Jeff-Birt/C2N_Adapter/Images/Adapter Rev6 PCB Bottom.PNG

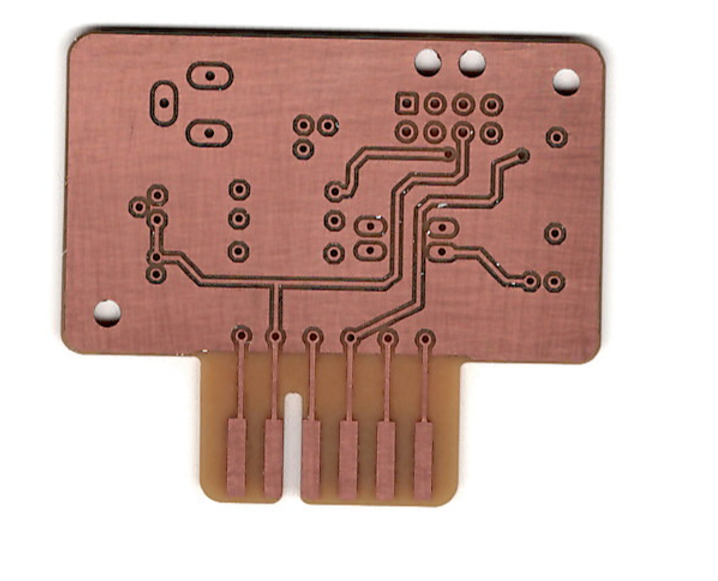
Images/Adapter Rev6 PCB Bottom.PNG
