Jeff-Birt/C2N_Adapter/Images/Adapter Rev6 PCB Top.PNG

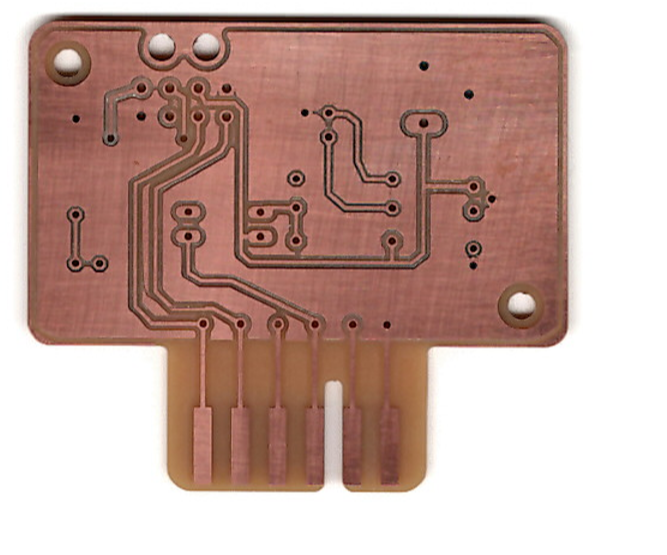
Images/Adapter Rev6 PCB Top.PNG
