Jeff-Birt/C2N_Adapter/Data/Cassette Adapter BOM.xlsx

Manufacturer | Part # | Qty | Description | Source | Price Ea. $ | Price Ext.
For adapter
AdaFruit | 373 | 1 | DC Power Jack, OD-5.5mm, ID-2.1mm | https://www.mouser.com/ProductDetail/485-373 | $0.95 | $0.95
Vishay | IRFD9014PBF | 1 | MOSFET Transistor, power switch | https://www.mouser.com/ProductDetail/844-IRFD9014PBF | $0.95 | $0.95
Molex | 43045-0800 | 1 | 2x4 Right Angle PCB count con. | https://www.mouser.com/ProductDetail/538-43045-0800 | $2.20 | $2.20
Molex | 538-43025-0800 | 1 | 2x4 Male connector housing | https://www.mouser.com/ProductDetail/538-43025-0800 | $0.52 | $0.52
Molex | 43030-0007 | 8 | Female crimp pins for above housing | https://www.mouser.com/ProductDetail/538-43030-0007 | $0.19 | $1.52
ON | LM2931AZ-5.0RPG | 1 | 5V Regulator, TO-92 case | https://www.mouser.com/ProductDetail/863-LM2931AZ-5.0RPG | $0.59 | $0.59
Misc | 2N222A | 1 | NPN Transistor | https://www.bgmicro.com/TRN2N2222AMetal.aspx | $0.27 | $0.27
Misc |  | 2 | 2.2K 1/4W resistor |  | $0.10 | $0.20
Misc |  | 1 | 10K 1/4W resistor |  | $0.10 | $0.10
Misc |  | 1 | 330ohm 1/4W resistor |  | $0.10 | $0.10
Misc |  | 1 | T1-3/4 LED |  | $0.10 | $0.10
Misc |  | 1 | 10uF 16V electrolytic capacitor |  | $0.10 | $0.10
For TI-94/74
Amphenol | 78211-010LF | 1 | 0.1" 1x10 Female housing | https://www.mouser.com/ProductDetail/649-78211-010LF | $1.28 | $1.28
Amphenol | 47715-000LF | 10 | Female crimp pins for above houing | https://www.mouser.com/ProductDetail/649-47715-000LF | $0.42 | $4.20
 |  |  |  | Total |  | $13.08
