Jeff-Birt/C2N_Adapter/HH-3465 Inspired Model/HH-3465 Assembly.stp

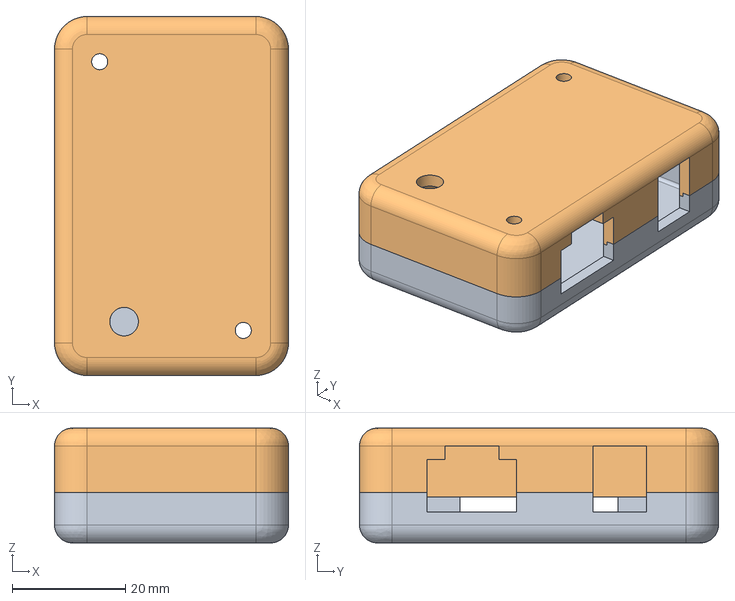
[picture p3: CAD file, 2018-11-23]
HH-3465 Inspired Model/HH-3465 Assembly.stp
41.4 x 63.5 x 20.3 mm
Bottom
Top
