Jeff-Birt/C2N_Adapter/HH-3465 Inspired Model/Top.stp

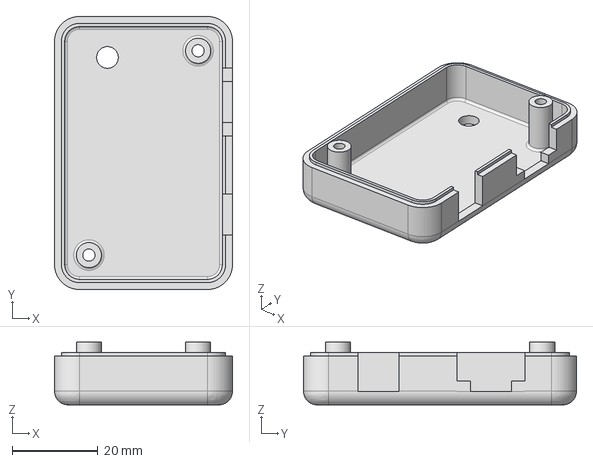
[picture p4: CAD file, 2018-11-23]
HH-3465 Inspired Model/Top.stp
41.4 x 63.5 x 14.6 mm
