Jeff-Birt/C2N_Adapter/HH-3465 Inspired Model/Bottom.stp

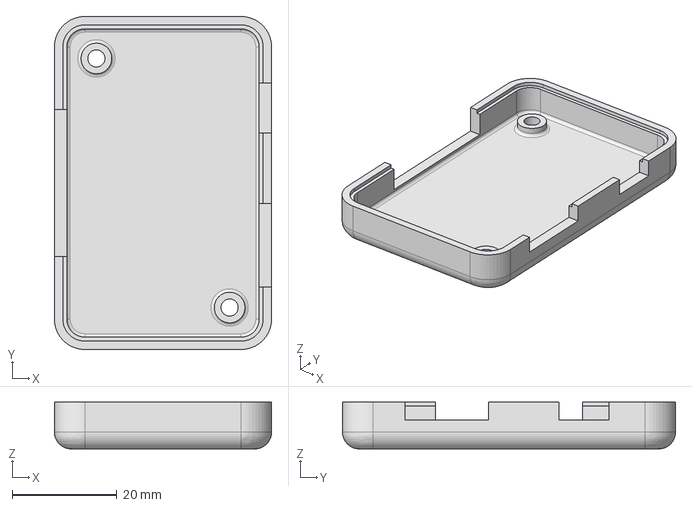
[picture p5: CAD file, 2018-11-23]
HH-3465 Inspired Model/Bottom.stp
41.4 x 63.5 x 8.92 mm
