Jeff-Birt/C2N_Adapter/HH-3465 Inspired Model/hb3465.dxf

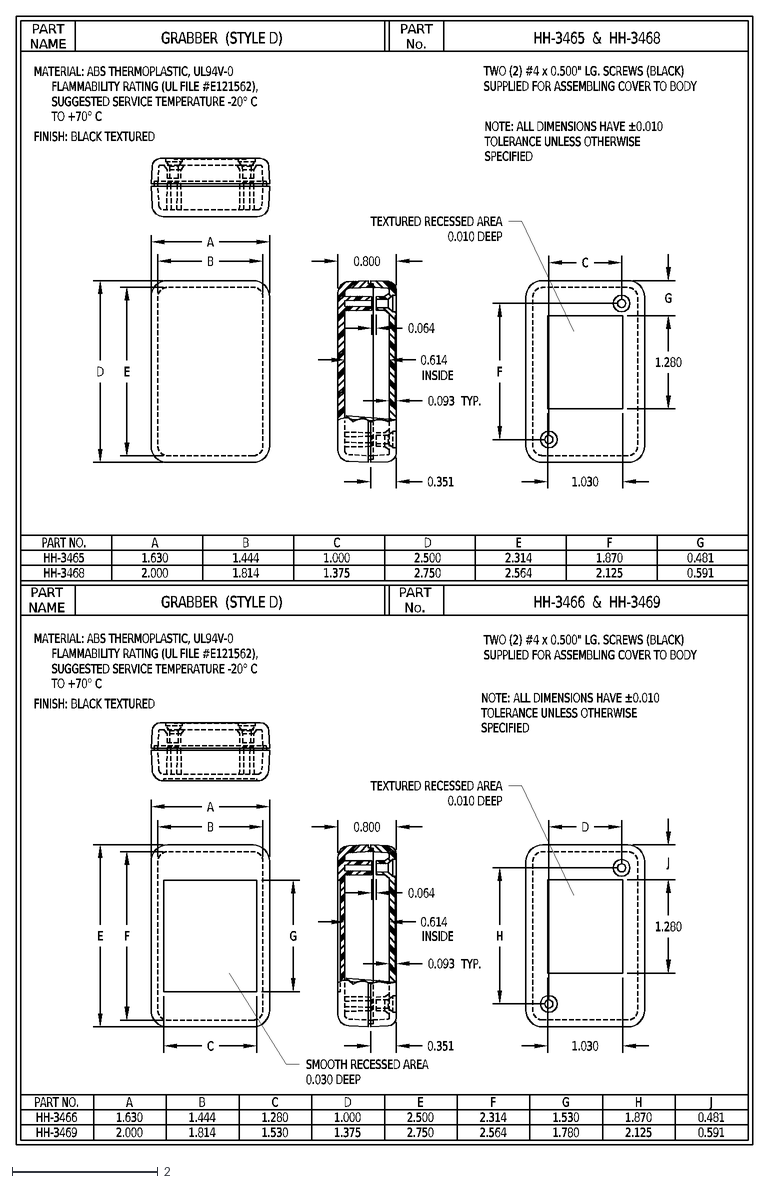
[picture p6: CAD file, 2018-11-23]
HH-3465 Inspired Model/hb3465.dxf
NAME
PART
No.
PART NO.
HH-3466
HH-3469
GRABBER (STYLE D)
TWO (2) #4 x 0.500" LG. SCREWS (BLACK)
SUPPLIED FOR ASSEMBLING COVER TO BODY
NOTE: ALL DIMENSIONS HAVE ±0.010
TOLERANCE UNLESS OTHERWISE
SPECIFIED
0.800
A
E
TYP.
0.093
HH-3465 & HH-3468
HH-3466 & HH-3469
FINISH: BLACK TEXTURED
SUGGESTED SERVICE TEMPERATURE -20° C
FLAMMABILITY RATING (UL FILE #E121562),
MATERIAL: ABS THERMOPLASTIC, UL94V-0
C
G
1.030
1.280
0.351
0.614
B
F
J
D
H
2.000
1.630
1.814
1.444
1.530
1.375
1.000
2.750
2.500
2.564
2.314
1.780
2.125
1.870
0.591
0.481
HH-3468
HH-3465
TEXTURED RECESSED AREA
0.010 DEEP
INSIDE
SMOOTH RECESSED AREA
0.030 DEEP
0.064
TO +70° C
