Jeff-Birt/C2N_Adapter/(list of files, cad)

Other CAD files:
HH-3465 Inspired Model/3D Print Files/Bottom.stl
HH-3465 Inspired Model/3D Print Files/Top.stl
HH-3465 Inspired Model/Bottom.igs
HH-3465 Inspired Model/Bottom.ipt
HH-3465 Inspired Model/HH-3465 Assembly.dwg
HH-3465 Inspired Model/HH-3465 Assembly.iam
HH-3465 Inspired Model/HH-3465 Assembly.igs
HH-3465 Inspired Model/Top.igs
HH-3465 Inspired Model/Top.ipt
