Jeff-Birt/C2N_Adapter/Eagle PCB Files V6/Cassette adapter V6 Schematic.pdf

4 | 3 | 2 | 1
8 | 7 | 6 | 5

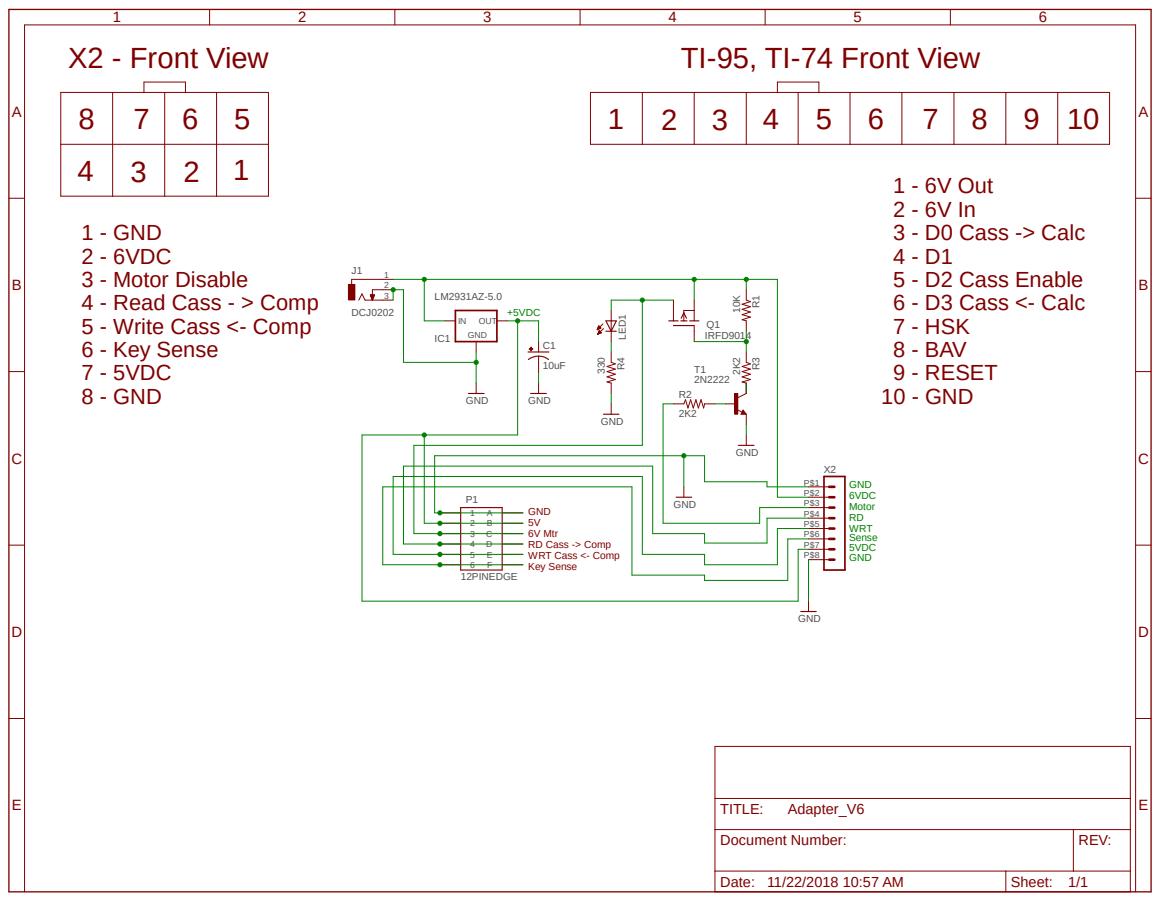
[picture p7: page 1]

TI-95, TI-74 Front View

Document Number: | REV:

Date: 11/22/2018 10:57 AM | Sheet: 1/1
