Jeff-Birt/C2N_Adapter/Data/Electronic Components/Connector_901560150_sd.pdf

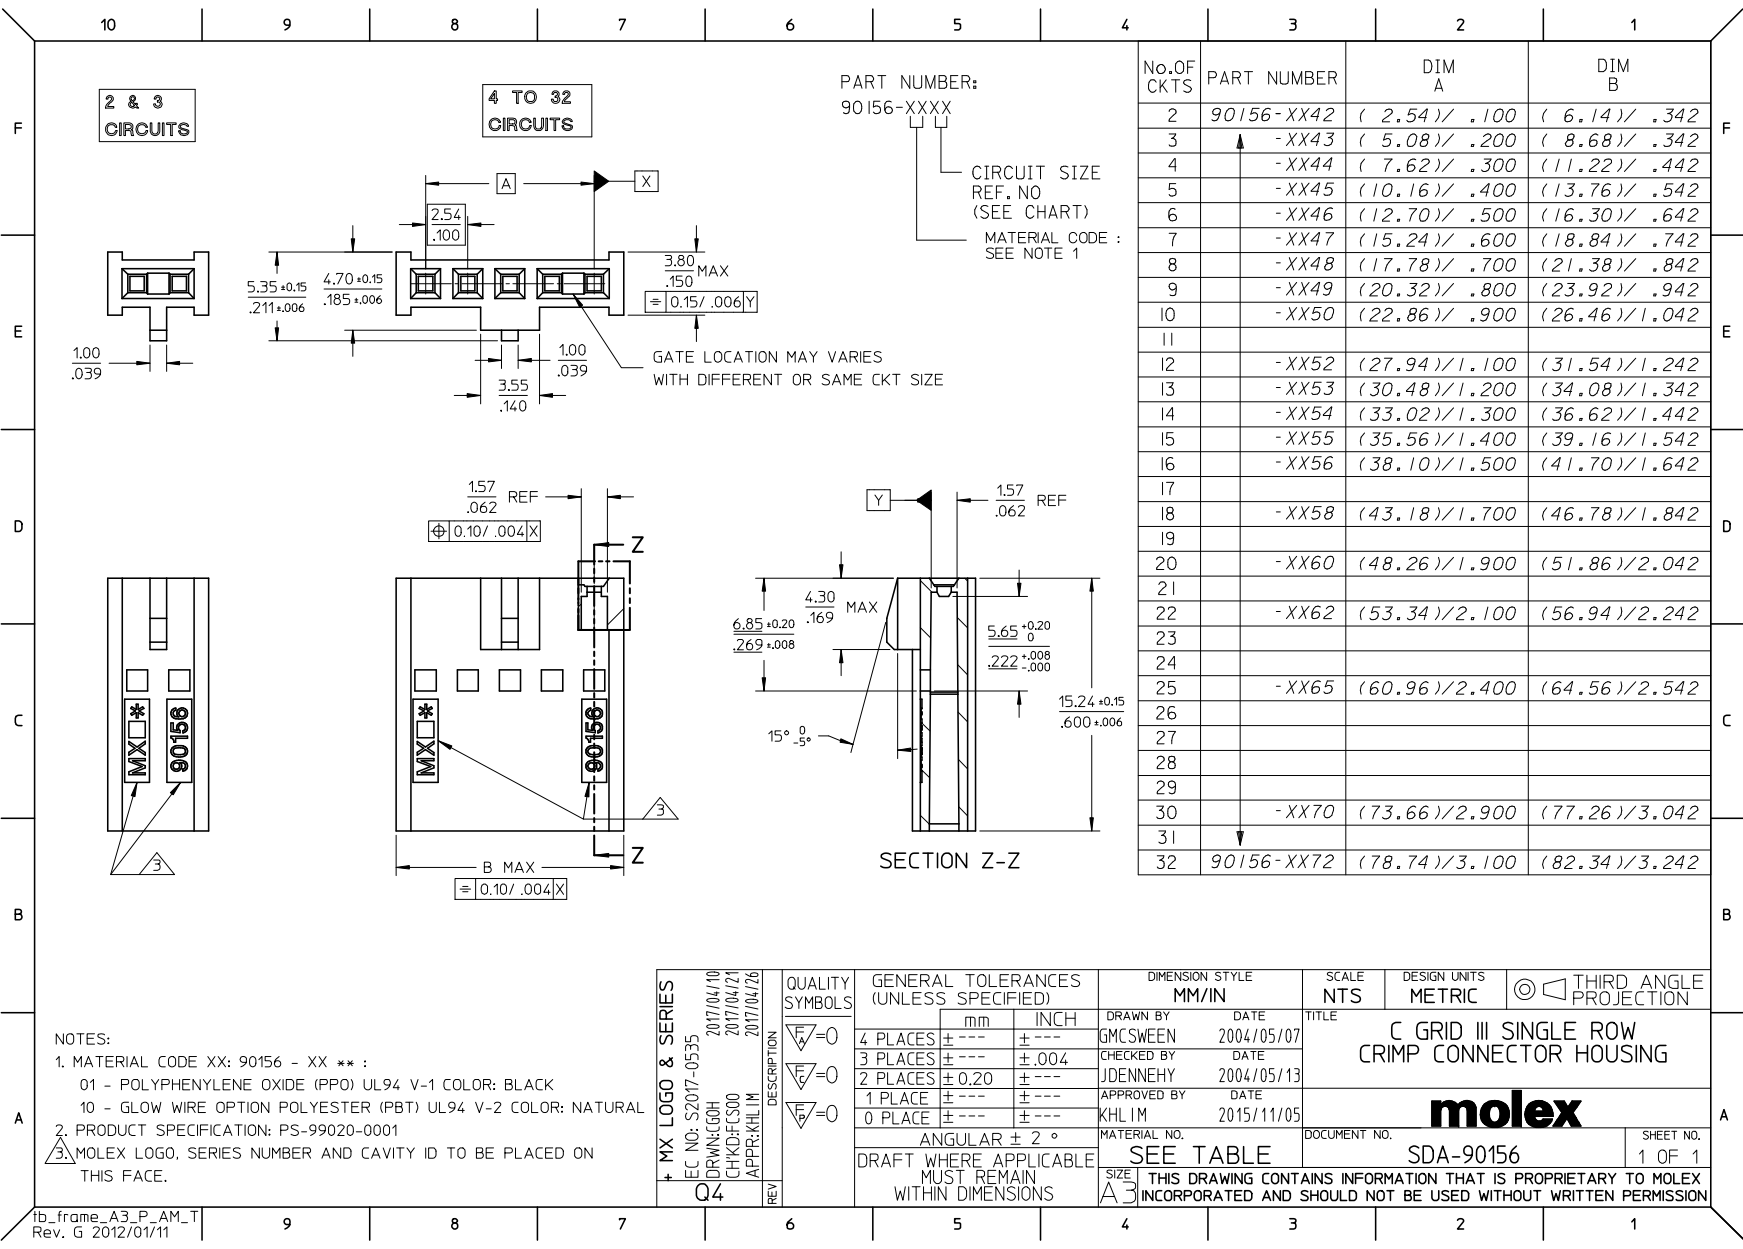
[picture p8: page 1]
