Jeff-Birt/C2N_Adapter/Data/Electronic Components/Molex_430300007_sd.pdf

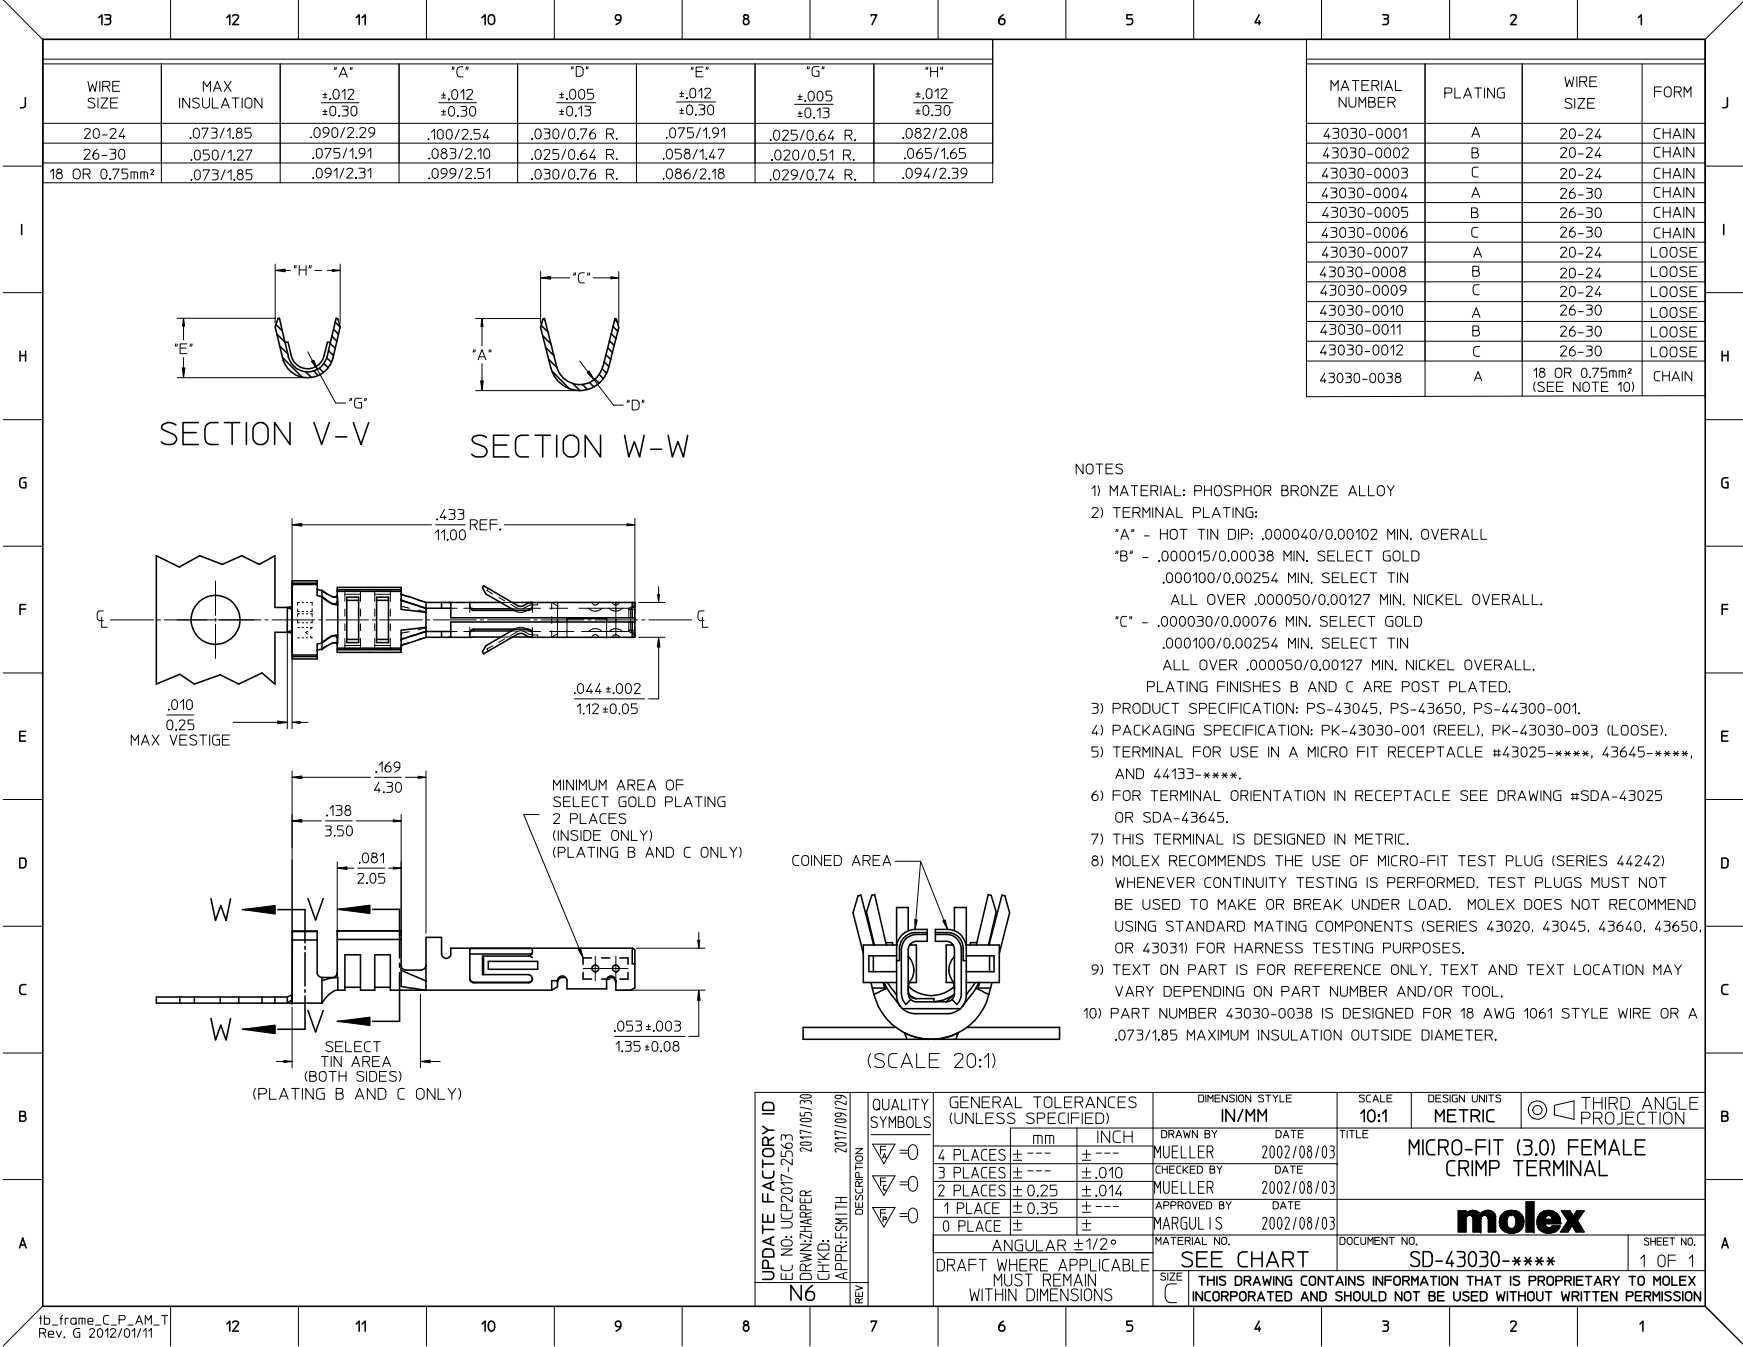
[picture p9: page 1]
