Jeff-Birt/C2N_Adapter/Data/Electronic Components/Molex_430450800_sd.pdf

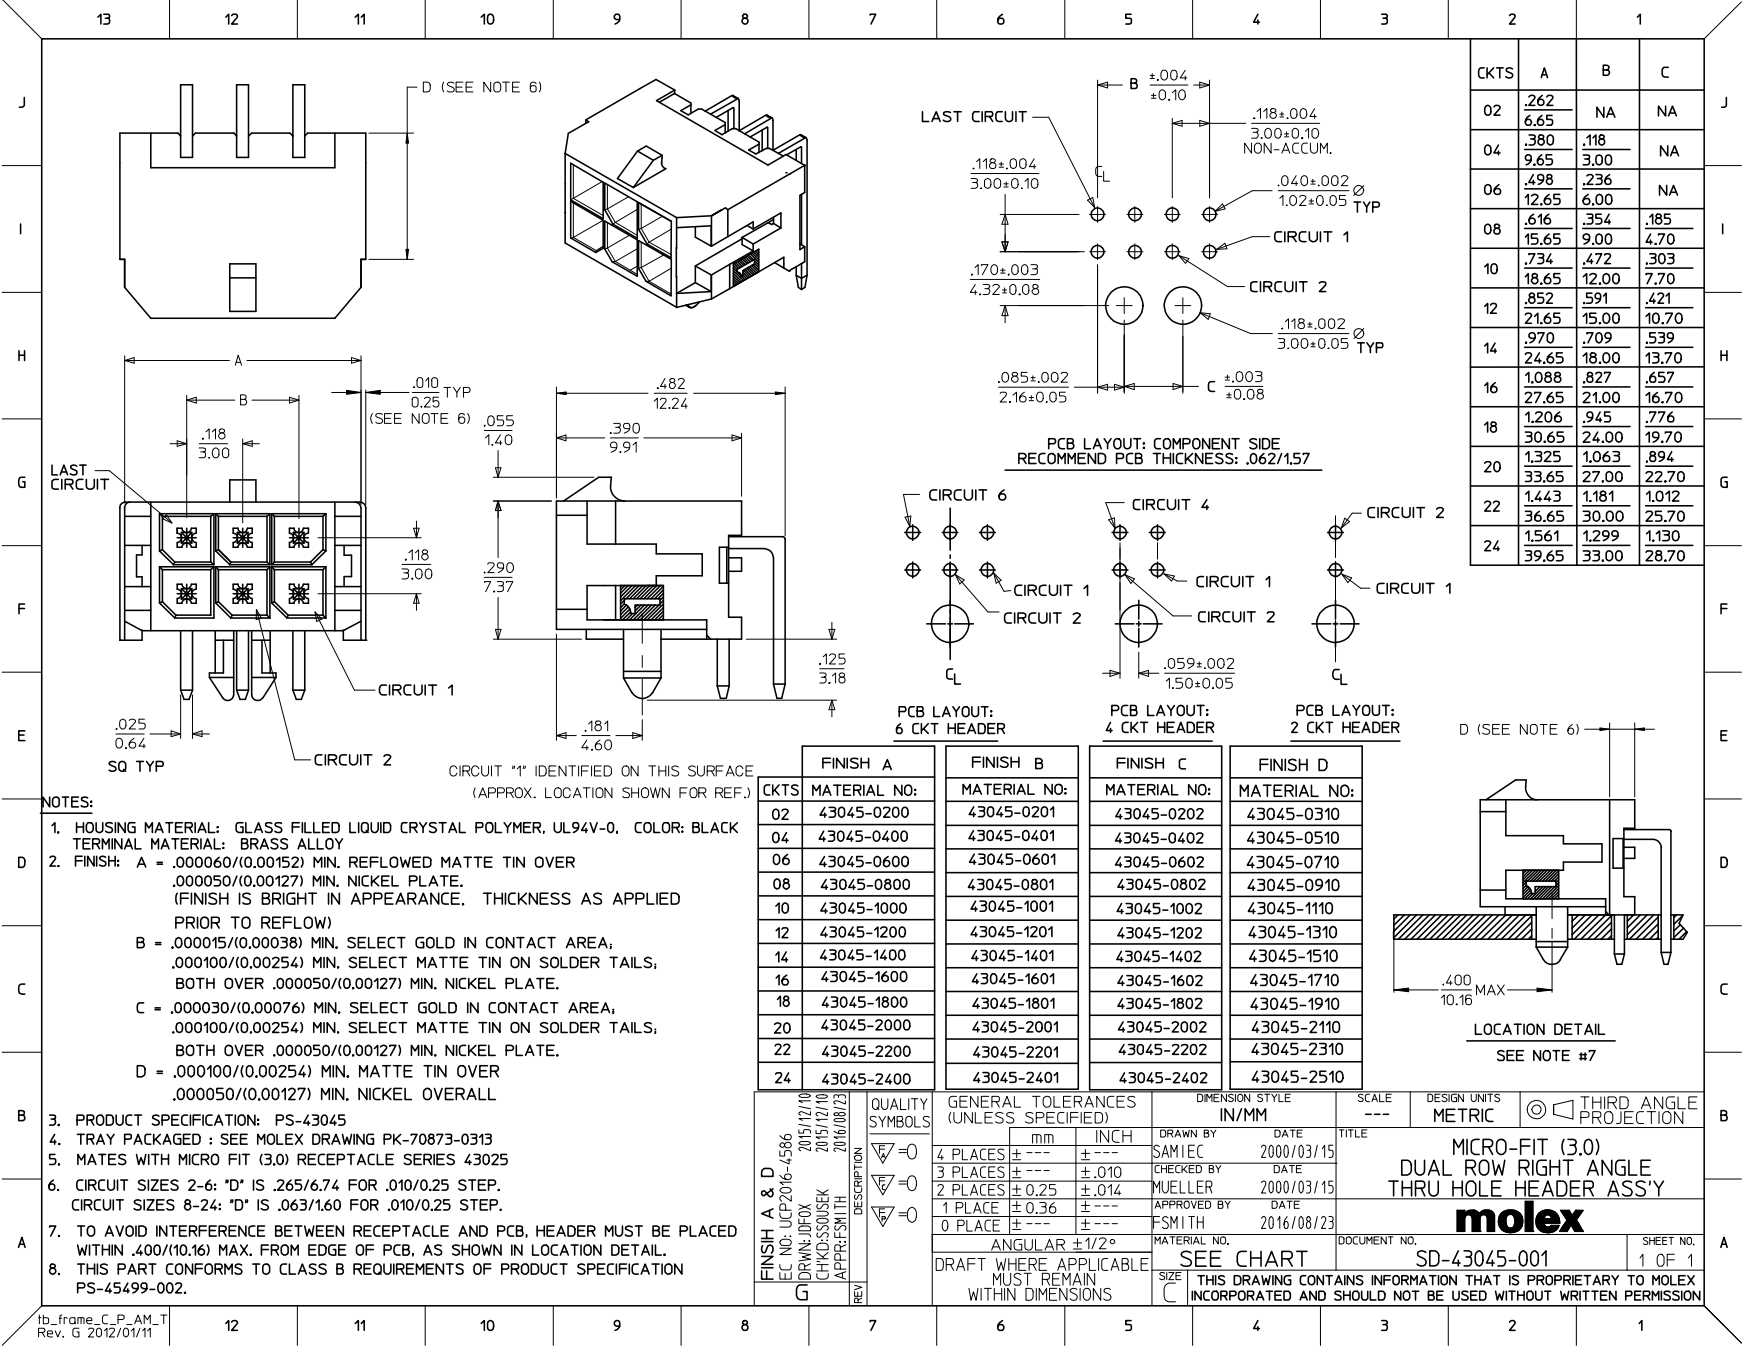
[picture p10: page 1]
