Jeff-Birt/C2N_Adapter/Data/Enclosures/hb3465.pdf

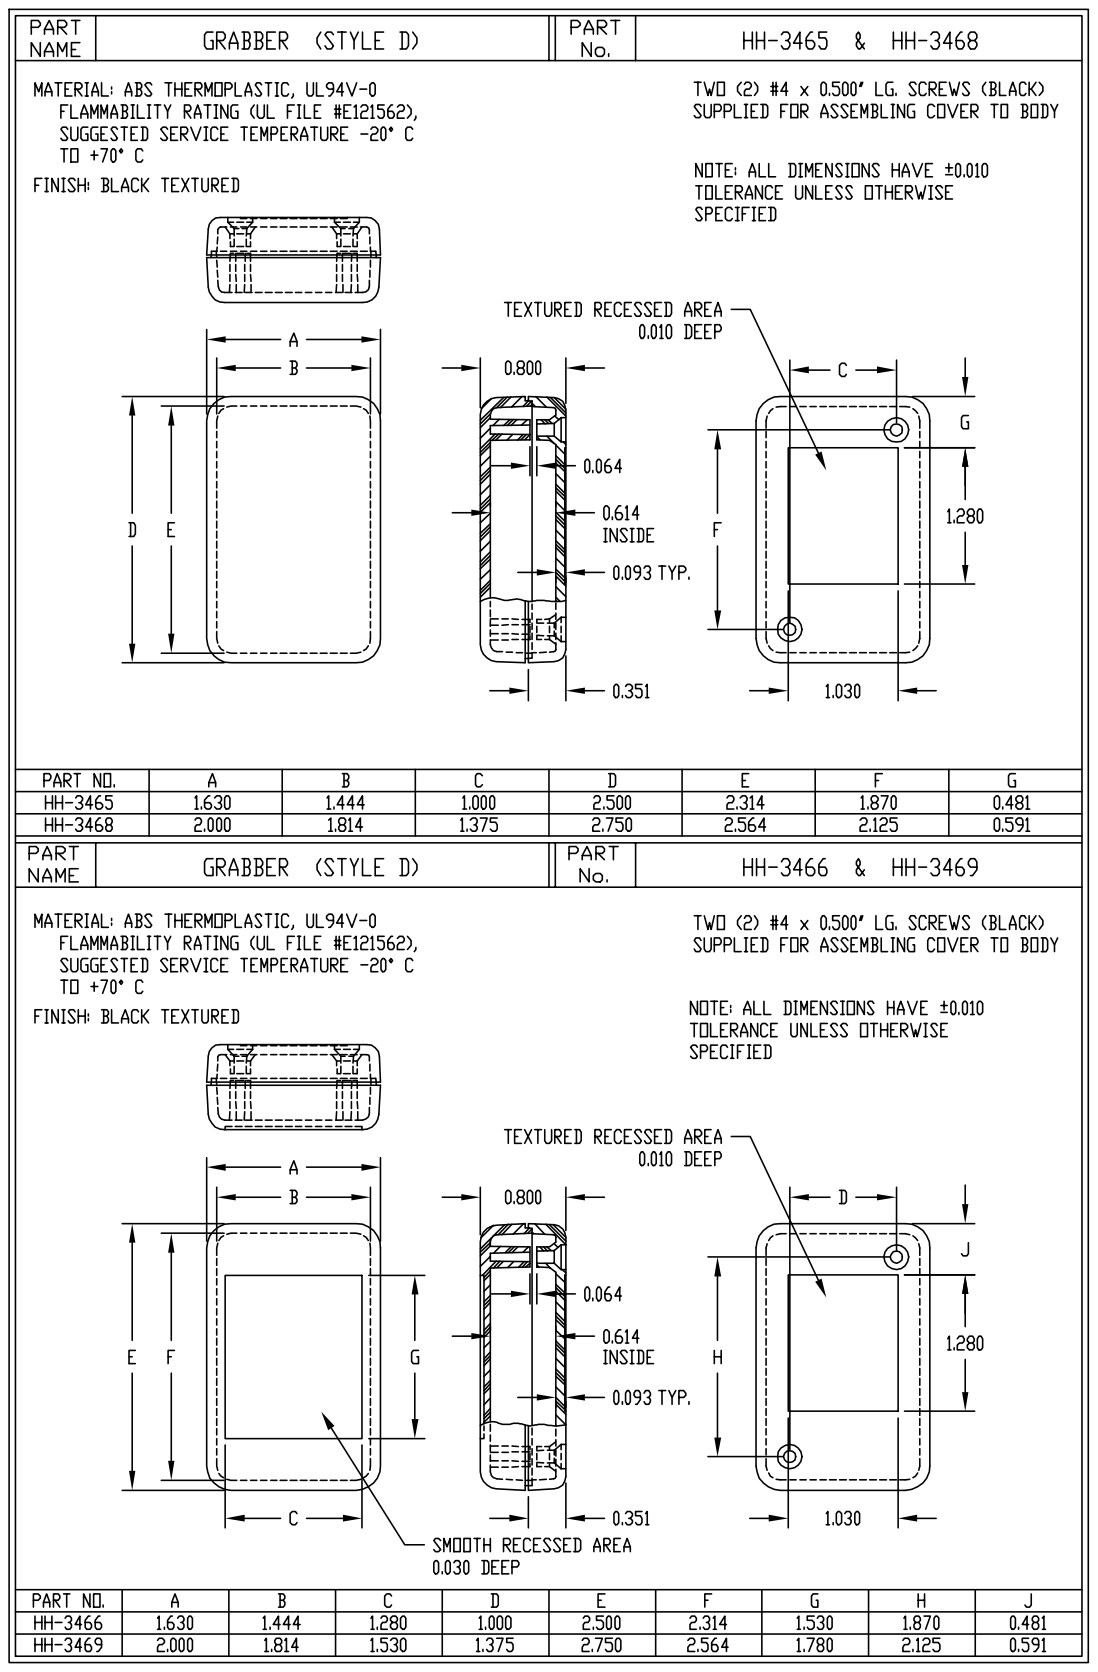
[picture p11: page 1]
