Jeff-Birt/C2N_Adapter/Eagle PCB Files V6/Adapter_V6.brd

## EAGLE design Eagle PCB Files V6/Adapter_V6.brd (2018-11-23)

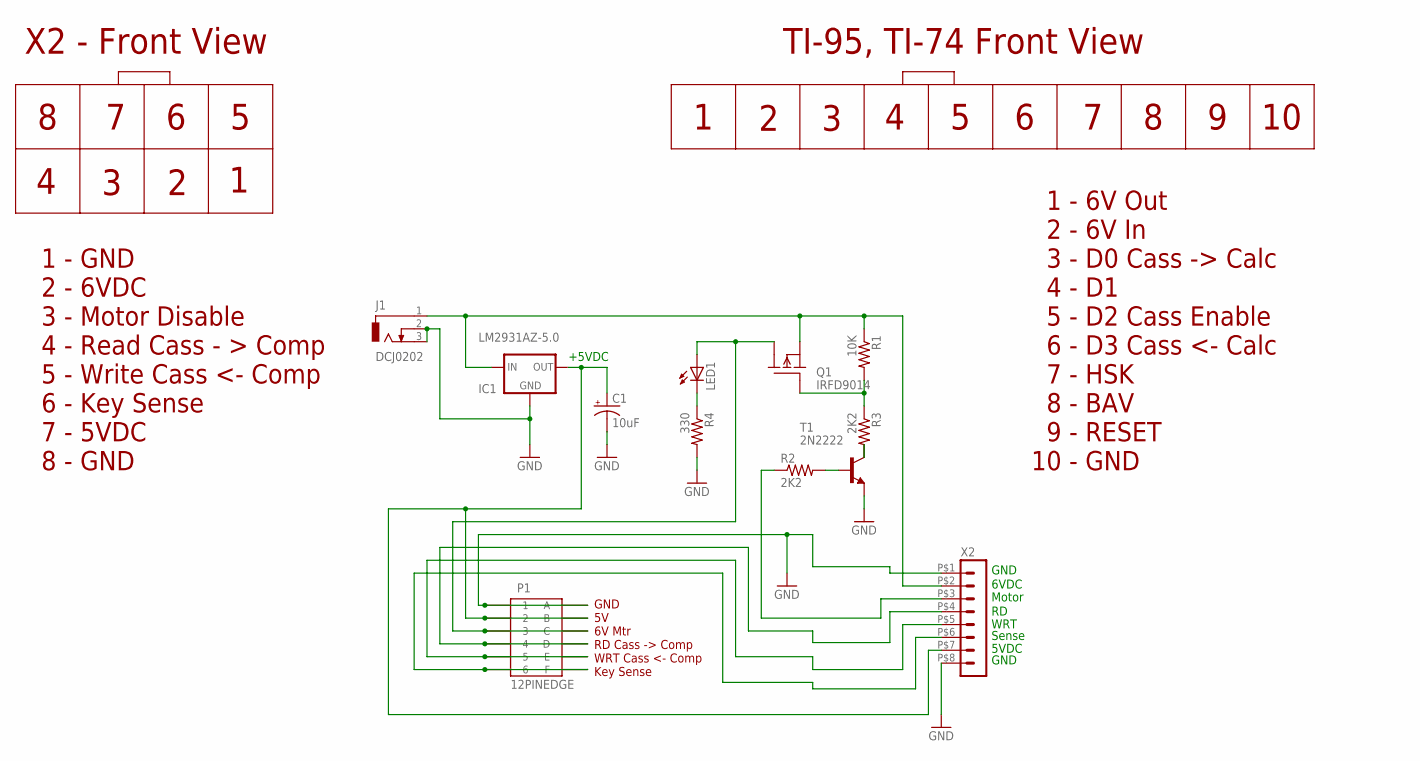
[picture p12: schematic Adapter_V6.sch]

Parts:
C1: 10uF; E1,8-4
IC1: LM2931AZ-5.0; TO92
J1: DCJ0202
LED1: LED5MM
P1: 12PINEDGE
Q1: IRFD9014; DIL04
R1: 10K; 0207/10
R2, R3: 2K2; 0207/10
R4: 330; 0207/10
T1: 2N2222; TO18
X2: HEADER_POS8_43045-0800; 43045-0800

Connections:
GND: C1.-, IC1.2 (GND), J1.2, J1.3, P1.1, P1.A, R4.2, T1.1 (E), X2.P$1 (1), X2.P$8 (8)
unnamed: IC1.3 (IN), J1.1, Q1.2 (S), R1.1, X2.P$2 (2)
unnamed: C1.+, IC1.1 (OUT), P1.2, P1.B, X2.P$7 (7)
unnamed: R2.1, X2.P$3 (3)
unnamed: P1.4, P1.D, X2.P$4 (4)
unnamed: P1.5, P1.E, X2.P$5 (5)
unnamed: P1.6, P1.F, X2.P$6 (6)
unnamed: R2.2, T1.2 (B)
unnamed: LED1.A, P1.3, P1.C, Q1.3 (D1)
unnamed: R3.2, T1.3 (C)
unnamed: Q1.1 (G), R1.2, R3.1
unnamed: LED1.K (C), R4.1

Notes on the sheet:
GND
+5VDC
Motor
WRT
Sense
6VDC
5VDC
X2 - Front View
1 - GND 2 - 6VDC 3 - Motor Disable 4 - Read Cass - > Comp 5 - Write Cass <- Comp 6 - Key Sense 7 - 5VDC 8 - GND
1 - 6V Out 2 - 6V In 3 - D0 Cass -> Calc 4 - D1 5 - D2 Cass Enable 6 - D3 Cass <- Calc 7 - HSK 8 - BAV 9 - RESET 10 - GND
TI-95, TI-74 Front View
GND 5V 6V Mtr RD Cass -> Comp WRT Cass <- Comp Key Sense

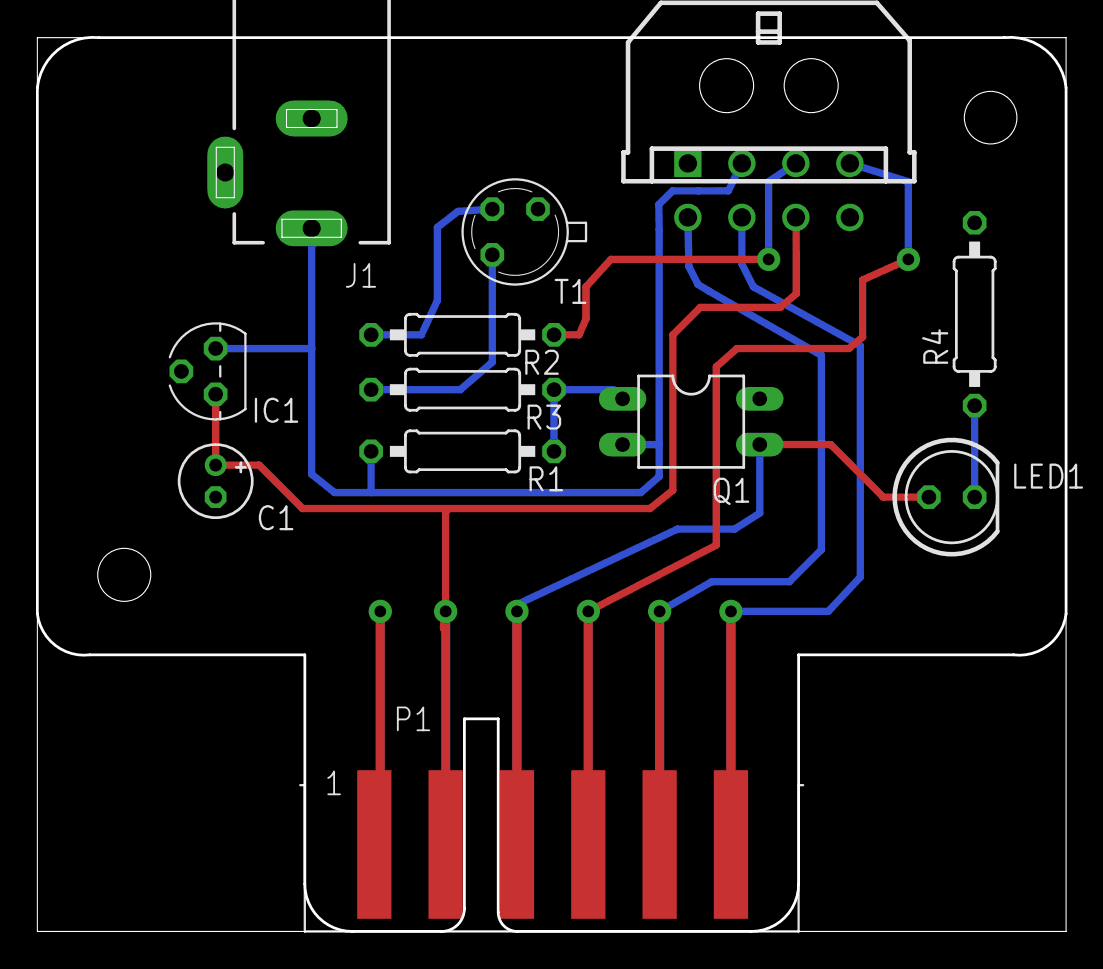
[picture p13: board Adapter_V6.brd from above]

Board: 2 copper layers, 57.1 x 49.7 mm, 12 parts (0 on the bottom side), 12 nets.
